andre17-hsx/peso-automatico-de-muestreo/hardware/pcb/render_bottom.png

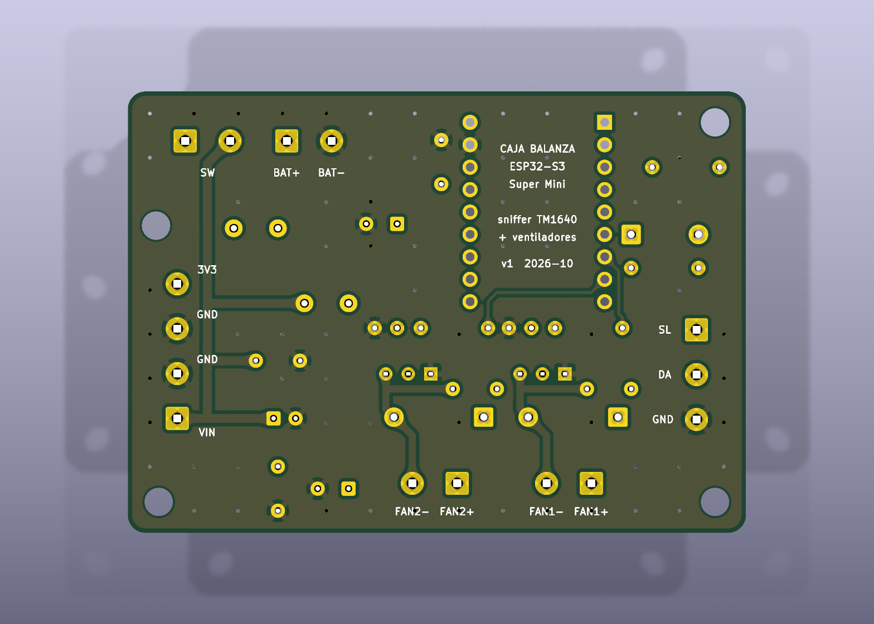
hardware/pcb/render_bottom.png
