andre17-hsx/peso-automatico-de-muestreo/hardware/pcb/render_iso.png

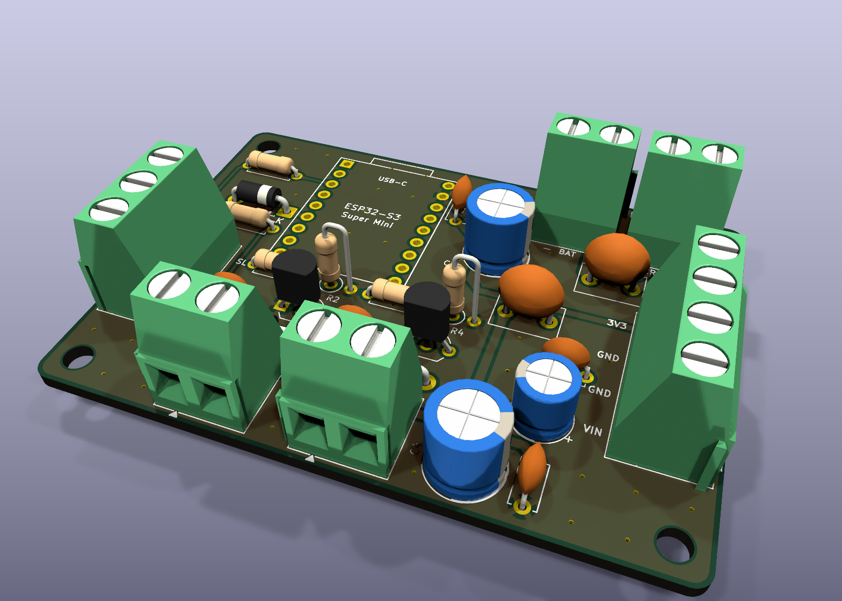
hardware/pcb/render_iso.png
