andre17-hsx/peso-automatico-de-muestreo/hardware/pcb/render_top.png

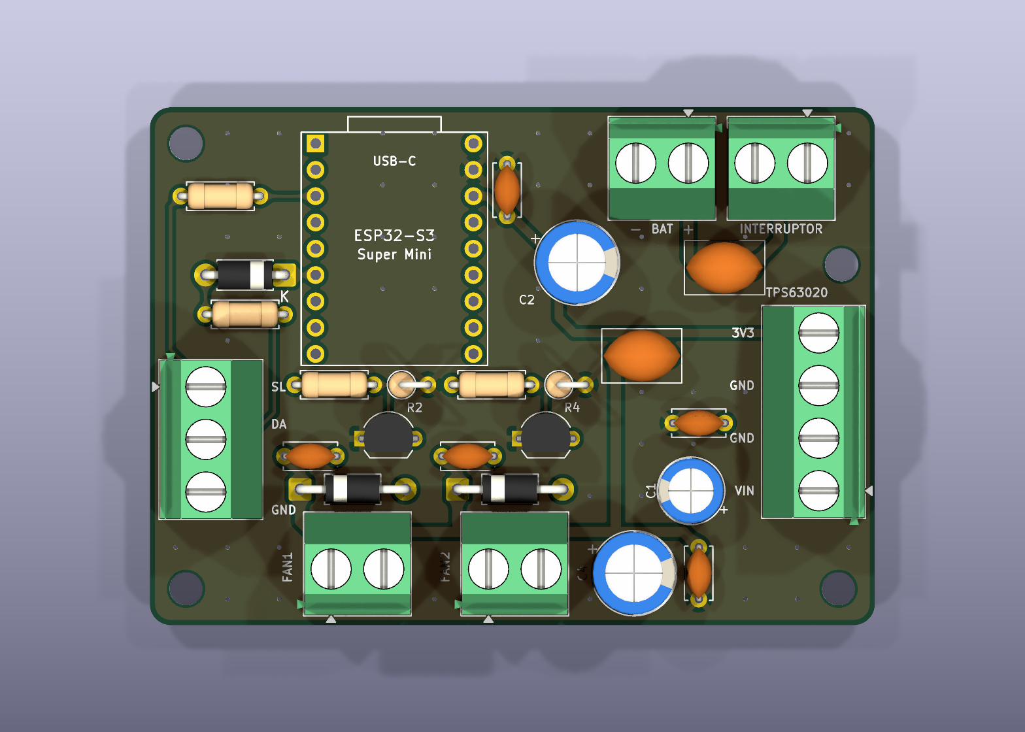
hardware/pcb/render_top.png
