andre17-hsx/peso-automatico-de-muestreo/hardware/pcb/v3/render_bottom.png

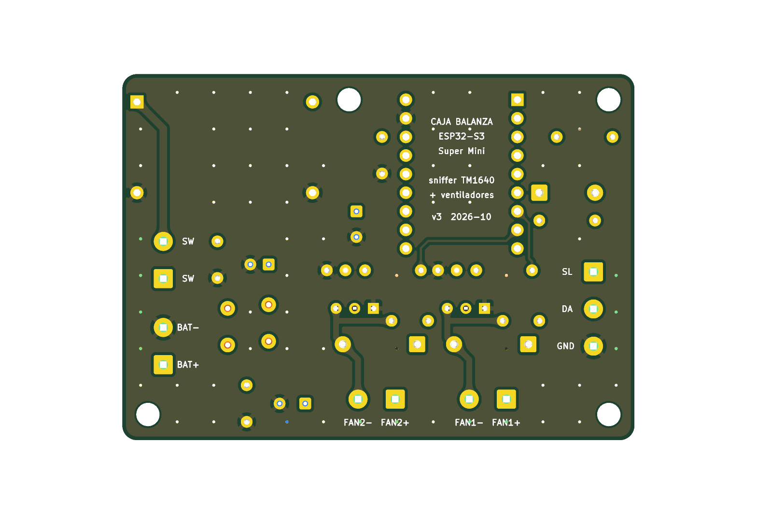
hardware/pcb/v3/render_bottom.png
