andre17-hsx/peso-automatico-de-muestreo/hardware/pcb/v3/render_iso.png

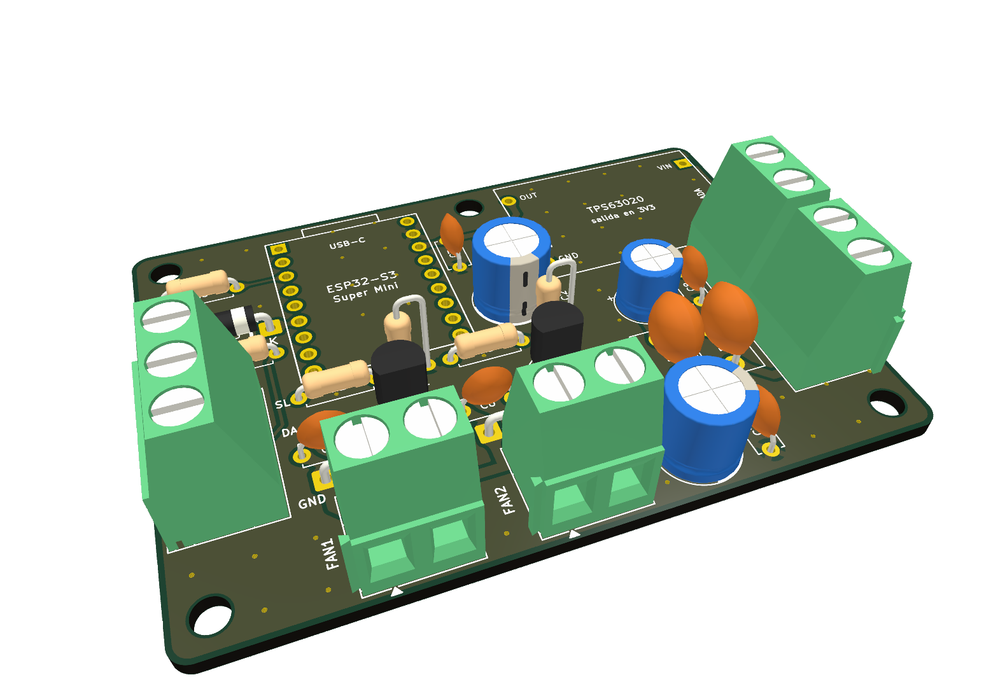
hardware/pcb/v3/render_iso.png
