andre17-hsx/peso-automatico-de-muestreo/hardware/pcb/BOM.csv

Ref | Qty | Value | Package / footprint | Note
U1 | 1 | ESP32-S3 Super Mini | 2 x 1x9 female headers, 2.54 mm (rows 15.24 mm apart) | The ESP keeps its male headers soldered and plugs in
J1 | 1 | 2-way terminal block (BAT - / +) | 5.08 mm, KF301 / MKDS 1.5 type | Scale battery
J2 | 1 | 2-way terminal block (SWITCH) | 5.08 mm | To the SW1 panel switch (>= 2 A)
J3 | 1 | 4-way terminal block (3V3 GND GND VIN) | 5.08 mm (or 2+2 interlocking) | To the TPS63020 module (short wires < 10 cm)
J4 J5 | 2 | 2-way terminal block (FAN + / -) | 5.08 mm | Red to +, black to -
J6 | 1 | 3-way terminal block (SL DA GND) | 5.08 mm | To the display connector
F1 | 1 | PTC 1.1 A hold (MF-R110) | radial, 5.1 mm lead pitch | Protects the whole board
F2 | 1 | PTC 0.75 A hold (MF-R075) | radial, 5.1 mm lead pitch | Fan branch only
C1 | 1 | 100 uF 16 V 105 C | electrolytic D6.3 mm, 2.5 mm pitch | TPS input
C8 | 1 | 10 uF 16 V X7R | ceramic, 5 mm pitch | TPS input
C2 | 1 | 470 uF 10 V 105 C | electrolytic D8 mm, 3.5 mm pitch | WiFi peaks, next to the 3V3 pin
C3 C5 C6 C7 | 4 | 100 nF 50 V (104) | ceramic, 5 mm pitch | Decoupling and motor noise
C4 | 1 | 470 uF 16 V 105 C | electrolytic D8 mm, 3.5 mm pitch | Fan start-up
R1 R3 R5 R6 | 4 | 470 ohm 1/4 W | axial, 7.62 mm pitch (lying flat) | yellow-violet-brown
R2 R4 | 2 | 10 kohm 1/4 W | axial standing, 2.54 mm pitch | brown-black-orange
Q1 Q2 | 2 | 2N2222 / PN2222A | TO-92, legs spread to 2.54 mm | E-B-C order (square = E), check with a multimeter
D1 D2 | 2 | 1N5819 | DO-41, 10.16 mm pitch | Band toward the square pad (cathode, +V_VENT side)
D3 | 1 | 1N5819 (or BAT85) | DO-41, 7.62 mm pitch | Band toward the ESP (square pad)
H1-H4 | 4 | M3 screw + standoff | 3.2 mm hole
