andre17-hsx/peso-automatico-de-muestreo/hardware/pcb/esquema_caja_balanza.pdf

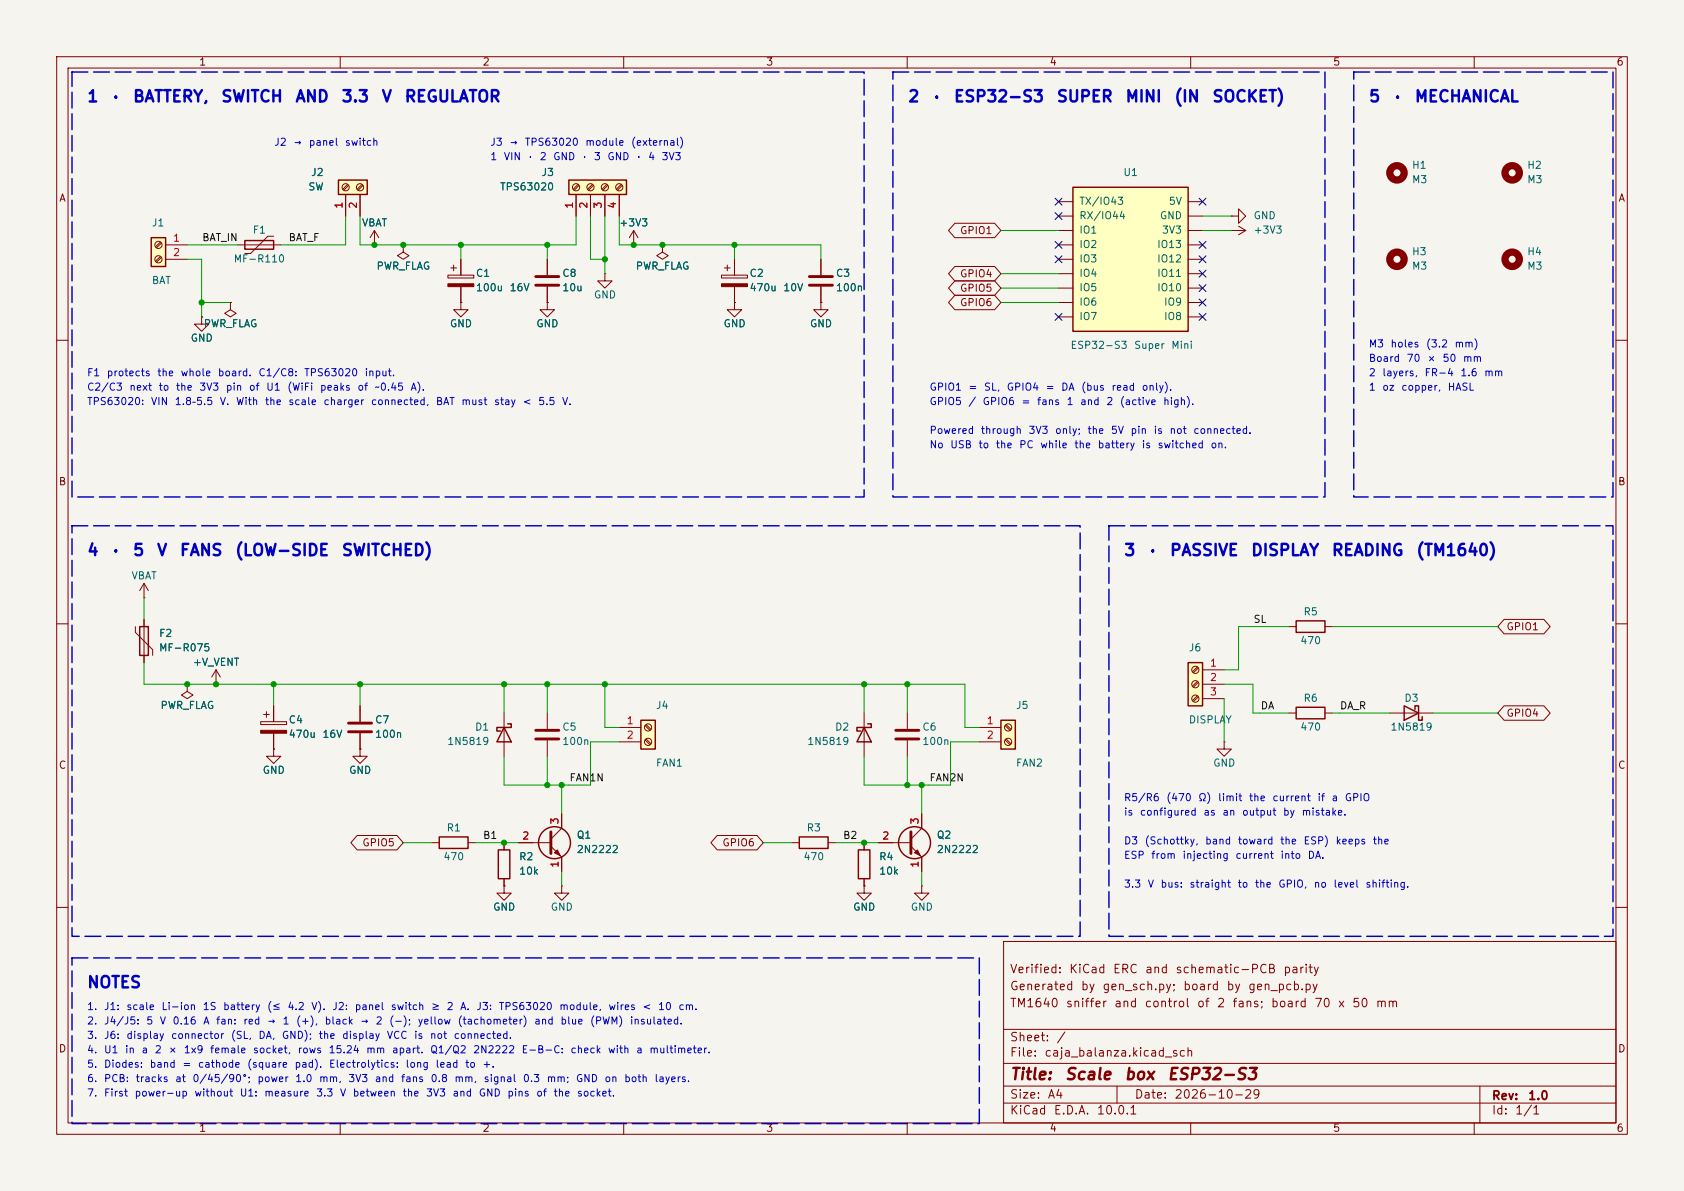
[picture p12: page 1]

1 · BATTERY, SWITCH AND 3.3 V REGULATOR

2 · ESP32-S3 SUPER MINI (IN SOCKET)

TPS63020: VIN 1.8–5.5 V. With the scale charger connected, BAT must stay < 5.5 V. C2/C3 next to the 3V3 pin of U1 (WiFi peaks of ~0.45 A). F1 protects the whole board. C1/C8: TPS63020 input.

1 oz copper, HASL 3 · PASSIVE DISPLAY READING (TM1640)

GPIO5 / GPIO6 = fans 1 and 2 (active high).

7. First power-up without U1: measure 3.3 V between the 3V3 and GND pins of the socket. 2. J4/J5: 5 V 0.16 A fan: red → 1 (+), black → 2 (−); yellow (tachometer) and blue (PWM) insulated. 1. J1: scale Li-ion 1S battery (≤ 4.2 V). J2: panel switch ≥ 2 A. J3: TPS63020 module, wires < 10 cm. 4 · 5 V FANS (LOW-SIDE SWITCHED)

is configured as an output by mistake. D3 (Schottky, band toward the ESP) keeps the ESP from injecting current into DA. 3.3 V bus: straight to the GPIO, no level shifting.

Verified: KiCad ERC and schematic-PCB parity
Generated by gen_sch.py; board by gen_pcb.py
TM1640 sniffer and control of 2 fans; board 70 x 50 mm

3. J6: display connector (SL, DA, GND); the display VCC is not connected.
4. U1 in a 2 × 1x9 female socket, rows 15.24 mm apart. Q1/Q2 2N2222 E-B-C: check with a multimeter.
5. Diodes: band = cathode (square pad). Electrolytics: long lead to +. 6. PCB: tracks at 0/45/90°; power 1.0 mm, 3V3 and fans 0.8 mm, signal 0.3 mm; GND on both layers.

Size: A4 | Rev: 1.0
KiCad E.D.A. 10.0.1 | Id: 1/1
