andre17-hsx/peso-automatico-de-muestreo/hardware/pcb/v2/caja_balanza_v2.kicad_pcb

## KiCad design hardware/pcb/v2/caja_balanza_v2.kicad_pcb (2026-10-29, an earlier design)

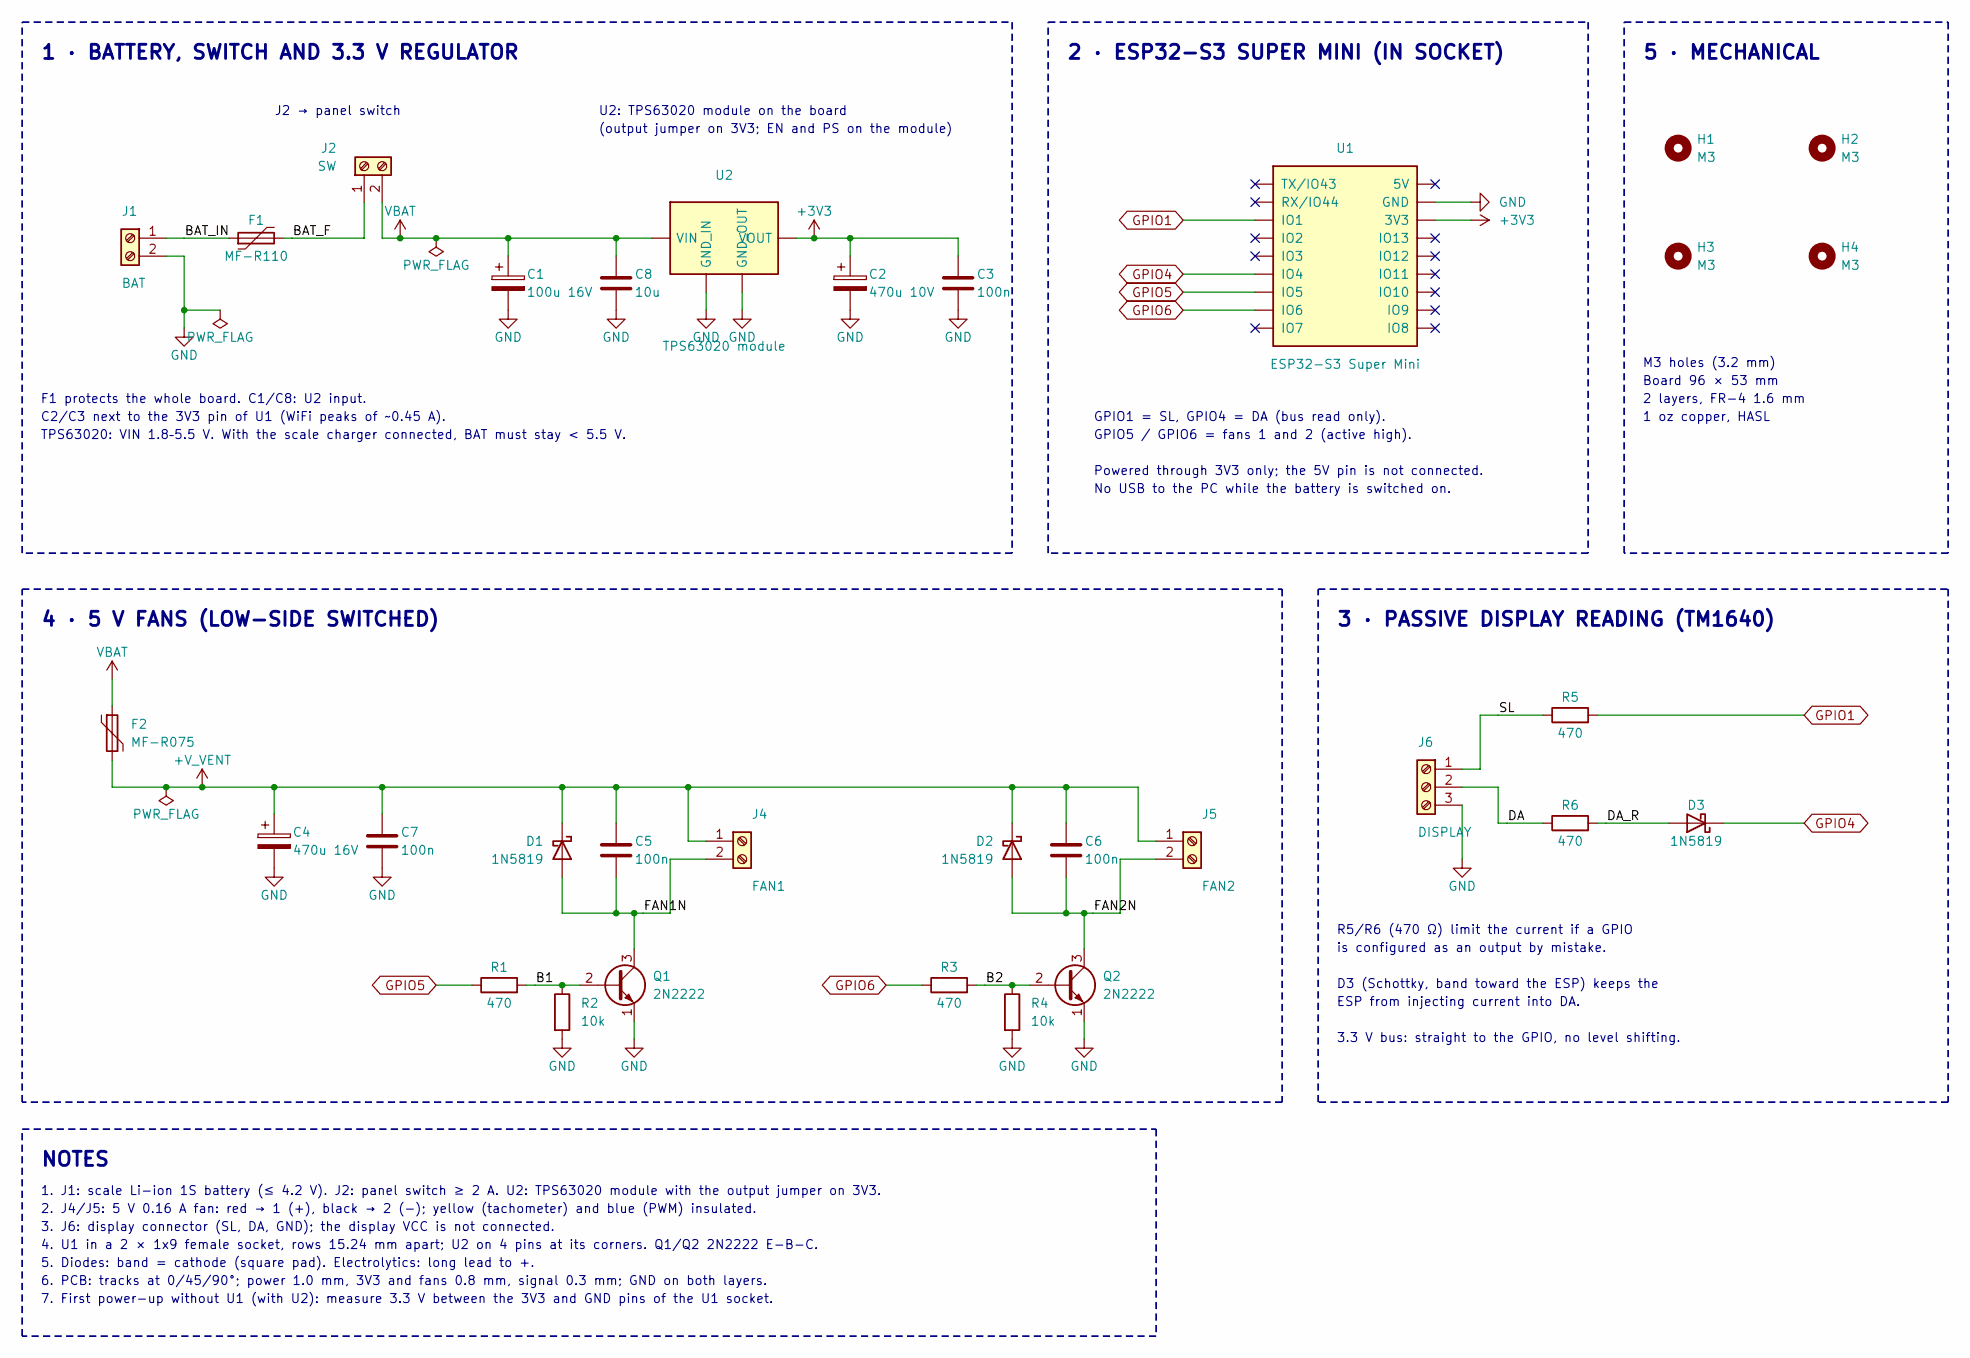
[picture p14: schematic caja_balanza_v2.kicad_sch, Scale box ESP32-S3]

Parts:
C1: 100u 16V; CP_Radial_D6.3mm_P2.50mm
C2: 470u 10V; CP_Radial_D8.0mm_P3.50mm
C3, C5, C6, C7: 100n; C_Disc_D5.0mm_W2.5mm_P5.00mm
C4: 470u 16V; CP_Radial_D8.0mm_P3.50mm
C8: 10u; C_Disc_D5.0mm_W2.5mm_P5.00mm
D1, D2: 1N5819; D_DO-41_SOD81_P10.16mm_Horizontal
D3: 1N5819; D_DO-41_SOD81_P7.62mm_Horizontal
F1: MF-R110; C_Disc_D7.5mm_W5.0mm_P5.00mm
F2: MF-R075; C_Disc_D7.5mm_W5.0mm_P5.00mm
H1, H2, H3, H4: M3; MountingHole_3.2mm_M3
J1: BAT; TerminalBlock_Phoenix_MKDS-1,5-2-5.08_1x02_P5.08mm_Horizont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
J2: SW; TerminalBlock_Phoenix_MKDS-1,5-2-5.08_1x02_P5.08mm_Horizont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
J4: FAN1; TerminalBlock_Phoenix_MKDS-1,5-2-5.08_1x02_P5.08mm_Horizont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
J5: FAN2; TerminalBlock_Phoenix_MKDS-1,5-2-5.08_1x02_P5.08mm_Horizont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
J6: DISPLAY; TerminalBlock_Phoenix_MKDS-1,5-3-5.08_1x03_P5.08mm_Horizont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
Q1, Q2: 2N2222; TO-92_Inline_Wide
R1, R3, R5, R6: 470; R_Axial_DIN0207_L6.3mm_D2.5mm_P7.62mm_Horizontal
R2, R4: 10k; R_Axial_DIN0207_L6.3mm_D2.5mm_P7.62mm_Horizontal
U1: ESP32-S3 Super Mini; ESP32-S3_SuperMini_Socket
U2: TPS63020 module; TPS63020_Module_26x18

Connections:
+3V3: C2.1, C3.1, U1.3V3, U2.4 (VOUT)
+V_VENT: C4.1, C5.1, C6.1, C7.1, D1.1 (K), D2.1 (K), F2.2, J4.1, J5.1
/B1: Q1.2 (B), R1.2, R2.1
/B2: Q2.2 (B), R3.2, R4.1
/BAT_F: F1.2, J2.1
/BAT_IN: F1.1, J1.1
/DA: J6.2, R6.1
/DA_R: D3.2 (A), R6.2
/FAN1N: C5.2, D1.2 (A), J4.2, Q1.3 (C)
/FAN2N: C6.2, D2.2 (A), J5.2, Q2.3 (C)
/SL: J6.1, R5.1
GND: C1.2, C2.2, C3.2, C4.2, C7.2, C8.2, J1.2, J6.3, Q1.1 (E), Q2.1 (E), R2.2, R4.2, U1.GND, U2.2 (GND_IN), U2.3 (GND_OUT)
GPIO1: R5.2, U1.1 (IO1)
GPIO4: D3.1 (K), U1.4 (IO4)
GPIO5: R1.1, U1.5 (IO5)
GPIO6: R3.1, U1.6 (IO6)
VBAT: C1.1, C8.1, F2.1, J2.2, U2.1 (VIN)

Notes on the sheet:
1 · BATTERY, SWITCH AND 3.3 V REGULATOR
J2 → panel switch
U2: TPS63020 module on the board
(output jumper on 3V3; EN and PS on the module)
F1 protects the whole board. C1/C8: U2 input.
C2/C3 next to the 3V3 pin of U1 (WiFi peaks of ~0.45 A).
TPS63020: VIN 1.8–5.5 V. With the scale charger connected, BAT must stay < 5.5 V.
2 · ESP32-S3 SUPER MINI (IN SOCKET)
GPIO1 = SL, GPIO4 = DA (bus read only).
GPIO5 / GPIO6 = fans 1 and 2 (active high).
Powered through 3V3 only; the 5V pin is not connected.
No USB to the PC while the battery is switched on.
5 · MECHANICAL
M3 holes (3.2 mm)
Board 96 × 53 mm
2 layers, FR-4 1.6 mm
1 oz copper, HASL
4 · 5 V FANS (LOW-SIDE SWITCHED)
3 · PASSIVE DISPLAY READING (TM1640)
R5/R6 (470 Ω) limit the current if a GPIO
is configured as an output by mistake.
D3 (Schottky, band toward the ESP) keeps the
ESP from injecting current into DA.
3.3 V bus: straight to the GPIO, no level shifting.
NOTES
1. J1: scale Li-ion 1S battery (≤ 4.2 V). J2: panel switch ≥ 2 A. U2: TPS63020 module with the output jumper on 3V3.
2. J4/J5: 5 V 0.16 A fan: red → 1 (+), black → 2 (−); yellow (tachometer) and blue (PWM) insulated.
3. J6: display connector (SL, DA, GND); the display VCC is not connected.
4. U1 in a 2 × 1x9 female socket, rows 15.24 mm apart; U2 on 4 pins at its corners. Q1/Q2 2N2222 E-B-C.
5. Diodes: band = cathode (square pad). Electrolytics: long lead to +.
6. PCB: tracks at 0/45/90°; power 1.0 mm, 3V3 and fans 0.8 mm, signal 0.3 mm; GND on both layers.
7. First power-up without U1 (with U2): measure 3.3 V between the 3V3 and GND pins of the U1 socket.

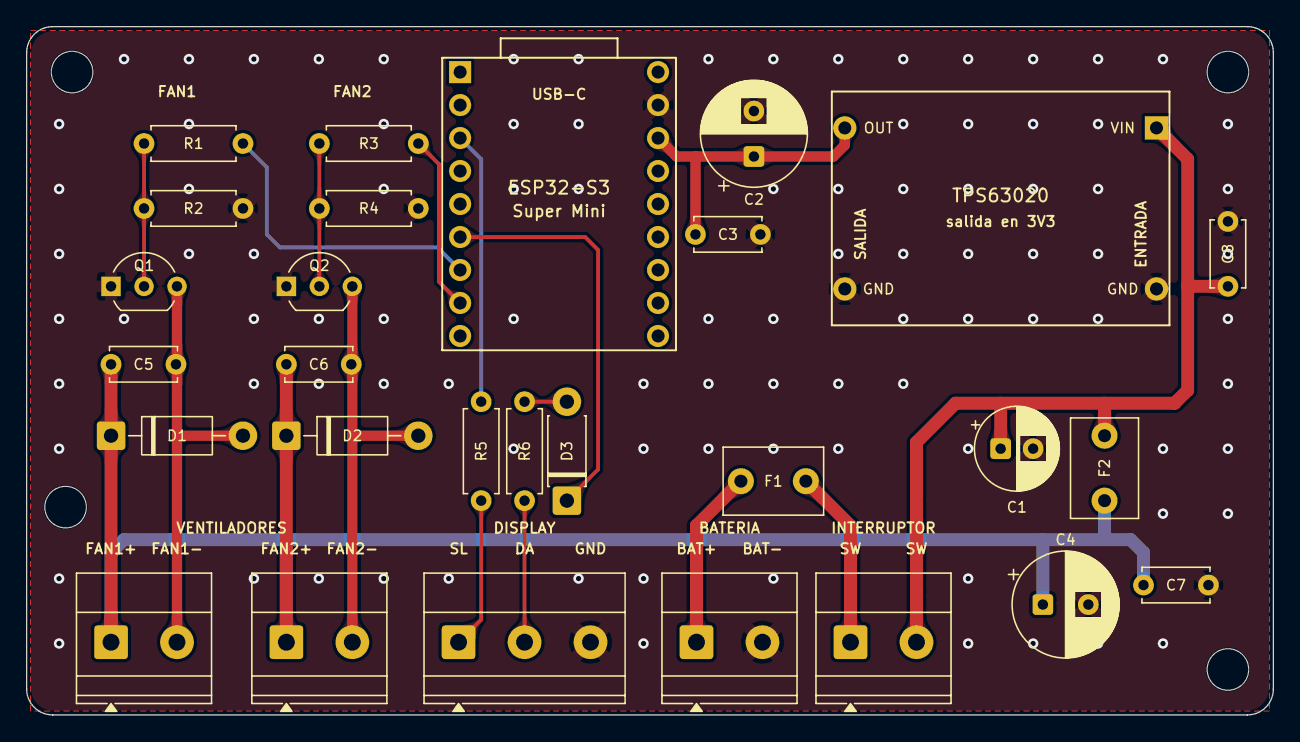
[picture p15: board caja_balanza_v2.kicad_pcb from above]

Board: 2 copper layers, 96.0 x 53.0 mm, 32 parts (0 on the bottom side), 17 nets.
