andre17-hsx/peso-automatico-de-muestreo/peso_balanza_cam/peso_balanza_cam.ino

/*
 * ===========================================================================
 *  peso_balanza_cam  -  Lee el PESO de la balanza cuenta-precio interceptando
 *                       el bus de su display y lo publica por WiFi (panel web).
 * ===========================================================================
 *
 *  Placa:   ESP32-S3 Super Mini  (chip ESP32-S3FH4R2: 4MB flash + 2MB PSRAM Quad,
 *           un solo USB-C nativo -- SIN chip CH340).
 *           (antes: DOIT ESP32-S3-WROOM N16R8 con FFC de camara; se cambio de
 *            modulo por daño de hardware.  Tambien se probo leer el display por
 *            camara/OCR -- ver el historial de git si hace falta recuperarlo --
 *            pero se descarto: el sniffer del bus da el valor EXACTO sin
 *            depender de luz/encuadre, asi que es lo unico que queda)
 *  Balanza: ACS-JC36CV28  -->  display WP-91110-2540-V7 (chip CS2540 == TM1640)
 *
 *  Sniffer del bus del display  (ENABLE_SNIFFER en config.h):
 *     escucha pasiva de DA (datos) y SL (reloj), decodifica el protocolo tipo
 *     TM1640 y reconstruye los 16 bytes de RAM -> PESO / PRECIO / TOTAL exactos.
 *     Corre en su PROPIA tarea de FreeRTOS (ver weighTaskFn mas abajo), asi que
 *     nunca se frena aunque el servidor web se quede esperando a un celular
 *     lento (WebServer puede tardar hasta 5 s en un cliente que no contesta).
 *
 * ---------------------------------------------------------------------------
 *  CONEXION DEL SNIFFER  (3 cables)  -- ver config.h
 * ---------------------------------------------------------------------------
 *     Balanza SL   --- [470 ohm] ------------------  GPIO1  (SNIF_PIN_SL)
 *     Balanza DA   --- [470 ohm] --- [diodo Schottky] --- GPIO4  (SNIF_PIN_DA)
 *                        (BAT54/1N5817/1N5819; anodo hacia la balanza, catodo
 *                         hacia el GPIO -- bloquea que una fuga interna del
 *                         ESP se devuelva hacia la balanza.  Ver README/chat:
 *                         asi se resolvio el bus "volviendose loco" con el
 *                         modulo anterior, que resulto tener 2 GPIO dañados
 *                         con fuga hacia el riel de 5V)
 *     Balanza GND  ------------------------------------------------  GND     (masa comun OBLIGATORIA)
 *
 *     NO conectar VCC_DIS.  Logica de 3 V -> entra directa al GPIO del S3.
 *     GPIO1 y GPIO4 limpios en esta placa.  Strapping S3 (0/3/45/46) y USB
 *     nativo (19/20) son del silicio, evitarlos sin importar la placa.  Esta
 *     placa no tiene conector de camara ni microSD, asi que ese bloqueo ya
 *     no aplica -- solo usa los 2 pines de arriba de todos modos.
 *     Durante la prueba: balanza con SU bateria, placa por USB-C.
 *
 * ---------------------------------------------------------------------------
 *  ARDUINO IDE   (chip ESP32-S3FH4R2 -- 4MB flash, 2MB PSRAM Quad)
 * ---------------------------------------------------------------------------
 *     Placa:              "ESP32S3 Dev Module"  (generico, sirve para esta placa)
 *     PSRAM:              "Disabled" (nada en este firmware la necesita)
 *     Flash Size:         "4MB (32Mb)"
 *     Partition Scheme:   uno pensado para 4MB que INCLUYA SPIFFS: ahi
 *                          (LittleFS) se guarda el historial COMPLETO de
 *                          pesajes (histarch.cpp); sin esa particion el
 *                          programa funciona igual, pero solo conserva los
 *                          ultimos 120.  El binario ocupa ~1,1 MB (no hay
 *                          OTA).  Pesajes que caben: "Minimal SPIFFS" (128KB)
 *                          ~4 000 · "Huge APP" (896KB) ~28 000 · "No OTA
 *                          (2MB APP/2MB SPIFFS)" ~61 000 (recomendado).
 *     USB CDC On Boot:    "Enabled"  (esta placa NO tiene CH340 -- solo el
 *                          USB-C nativo; si lo dejas en Disabled no vas a ver
 *                          NADA en el Monitor Serie)
 *     Core Debug Level:   "None"
 *
 *     Pon tu WiFi en config.h antes de compilar.
 * ===========================================================================
 */

#include <Arduino.h>
#include <WiFi.h>
#include <WebServer.h>
#include <ESPmDNS.h>
#include <time.h>
#include <stdlib.h>

#include "config.h"
#include "sniffer_tm1640.h"
#include "weighlog.h"
#include "diaglog.h"
#include "web_ui.h"
#include "weighsim.h"
#include "fan.h"
#include <esp_wifi.h>
#include <nvs.h>

// salud de la tarea del pesaje: loop() vigila que siga dando vueltas
static TaskHandle_t       g_weighTask   = nullptr;
static volatile uint32_t  g_weighBeatMs = 0;      // millis() de su ultima vuelta

#if WIFI_CAPTIVE
  #include <DNSServer.h>
  #include <esp_netif.h>
  DNSServer dnsServer;
  static bool g_apUp = false;      // hay un AP en marcha -> portal cautivo

  // Fuerza que el DHCP del AP entregue la IP del ESP como servidor DNS
  // (algunos cores no lo hacen solos y el portal cautivo no salta).
  static void apOfferOwnDns() {
    esp_netif_t* ni = esp_netif_get_handle_from_ifkey("WIFI_AP_DEF");
    if (!ni) return;
    esp_netif_dns_info_t dns; memset(&dns, 0, sizeof(dns));
    dns.ip.type = ESP_IPADDR_TYPE_V4;
    esp_netif_str_to_ip4("192.168.4.1", &dns.ip.u_addr.ip4);
    esp_netif_dhcps_stop(ni);
    esp_netif_set_dns_info(ni, ESP_NETIF_DNS_MAIN, &dns);
    uint8_t offerDns = 2;   // OFFER_DNS
    esp_netif_dhcps_option(ni, ESP_NETIF_OP_SET,
                           ESP_NETIF_DOMAIN_NAME_SERVER, &offerDns, sizeof(offerDns));
    esp_netif_dhcps_start(ni);
  }
#endif

WebServer server(80);

// Gracia tras levantar el AP: el driver puede soltar un AP_STOP espurio mientras
// termina de configurarse (y otro eco si lo relevantamos); no cuenta como caida.
#define AP_GRACE_MS 5000
static uint32_t g_apStartMs = 0;

// ---------------------------------------------------------------------------
static void wifiStartAP() {
  // IP fija 192.168.4.1; el DHCP del AP reparte esa misma IP como DNS -> hace
  // falta para el portal cautivo (el DNS "atrapatodo" del ESP).
  WiFi.softAPConfig(IPAddress(192, 168, 4, 1),
                    IPAddress(192, 168, 4, 1),
                    IPAddress(255, 255, 255, 0));
#ifdef WIFI_AP_CHANNEL
  WiFi.softAP(WIFI_AP_SSID, WIFI_AP_PASS, WIFI_AP_CHANNEL);
#else
  WiFi.softAP(WIFI_AP_SSID, WIFI_AP_PASS);
#endif
#ifdef WIFI_TX_POWER
  WiFi.setTxPower(WIFI_TX_POWER);
#endif
  Serial.printf("\n  ================ RED PROPIA DEL ESP32 ================\n"
                "   WiFi:   %s\n   Clave:  %s\n   Abrir:  http://%s/\n"
                "  =====================================================\n",
                WIFI_AP_SSID, WIFI_AP_PASS, WiFi.softAPIP().toString().c_str());
#if WIFI_CAPTIVE
  apOfferOwnDns();
  g_apUp = true;
#endif
  g_apStartMs = millis();      // arranca (o reinicia) la ventana de gracia
}

// ---------------------------------------------------------------------------
//  Auto-recuperacion del AP:  si el driver de WiFi lo llega a parar solo (p.
//  ej. por un bajon de tension momentaneo en la alimentacion), lo volvemos a
//  levantar.  Esto NO sustituye arreglar la alimentacion (C_out pendiente) --
//  es una red de seguridad para que el panel no se quede muerto hasta que
//  alguien reinicie el ESP a mano.
//
//  Dos vias, para cubrir los dos escenarios posibles:
//   1) El driver SI avisa (evento AP_STOP) -> reaccion inmediata.  El evento
//      llega en la tarea de WiFi, asi que aqui solo se marca una bandera; el
//      restart real lo hace loop() (evitar tocar el driver desde su propio
//      callback).
//   2) El driver NO avisa (se queda "zombie": el modo sigue en AP pero ya no
//      emite) -> red de seguridad barata: se revisa el modo cada 5 s,
//      aprovechando el heartbeat que ya existia (CERO temporizadores nuevos).
// ---------------------------------------------------------------------------
static volatile bool g_apNeedsRestart = false;
static uint32_t      g_apRecoverCount = 0;

static void wifiRecoverAP(const char* why) {
  g_apRecoverCount++;
  Serial.printf("[wifi] recuperando la red propia (%s) -> recuperacion #%lu\n",
                why, (unsigned long)g_apRecoverCount);
  diagLog("WIFI AP reinicio #%lu %s heap=%lu", (unsigned long)g_apRecoverCount, why,
          (unsigned long)ESP.getFreeHeap());
  wifiStartAP();
}

static void onWifiEvent(WiFiEvent_t event) {
  if (event == ARDUINO_EVENT_WIFI_AP_STOP) g_apNeedsRestart = true;   // lo procesa loop()
}

// Celulares que entran / salen de la red del ESP, para el registro (/log).
// Llega en la tarea de eventos de WiFi: solo se anota (sin floats ni esperas).
// motivo: 8 = el celular se fue · 3 = deauth · 4 = por inactividad ·
//         2 = autenticacion expirada · 15 = fallo de handshake
static void onWifiStaEvent(arduino_event_id_t ev, arduino_event_info_t info) {
  if (ev == ARDUINO_EVENT_WIFI_AP_STACONNECTED) {
    g_diagCnt.wifiConn++;
    diagLog("WIFI + cliente %02X:%02X aid=%d",
            (unsigned)info.wifi_ap_staconnected.mac[4], (unsigned)info.wifi_ap_staconnected.mac[5],
            (int)info.wifi_ap_staconnected.aid);
  } else if (ev == ARDUINO_EVENT_WIFI_AP_STADISCONNECTED) {
    g_diagCnt.wifiDisc++;
    diagLog("WIFI - cliente %02X:%02X motivo=%d",
            (unsigned)info.wifi_ap_stadisconnected.mac[4], (unsigned)info.wifi_ap_stadisconnected.mac[5],
            (int)info.wifi_ap_stadisconnected.reason);
  }
}

#if DIAG_LOG
// Resumen cada ~2 min para el registro: señal de cada celular, memoria y
// cuantos refrescos por segundo manda el display de la balanza.
static void diagStatus() {
  char rs[32] = "";
  int off = 0;
  wifi_sta_list_t sl;
  memset(&sl, 0, sizeof(sl));
  if (esp_wifi_ap_get_sta_list(&sl) == ESP_OK)
    for (int i = 0; i < sl.num && i < 4 && off < (int)sizeof(rs) - 6; i++)
      off += snprintf(rs + off, sizeof(rs) - off, "%d ", (int)sl.sta[i].rssi);
  unsigned fps = 0;
#if ENABLE_SNIFFER
  {
    static uint32_t lastCnt = 0, lastMs = 0;
    SnifState s; snifGet(s);
    uint32_t nowMs = millis();
    if (lastMs && nowMs > lastMs) fps = (unsigned)(((s.refreshCount - lastCnt) * 1000UL) / (nowMs - lastMs));
    lastCnt = s.refreshCount; lastMs = nowMs;
  }
#endif
  float tc = temperatureRead();                  // temperatura interna del chip (aprox., +-2-3 C)
  if (tc > g_diagCnt.tempMaxC) g_diagCnt.tempMaxC = tc;
  // formato compacto: con 4 celulares sigue cabiendo en los 64 caracteres de la linea
  diagLog("ST c=%d t=%.0f r[%s] h=%lu/%lu f=%u", WiFi.softAPgetStationNum(), (double)tc, rs,
          (unsigned long)ESP.getFreeHeap(), (unsigned long)ESP.getMinFreeHeap(), fps);
  // memoria contigua mas grande (fragmentacion), pila libre minima de cada tarea y
  // entradas de NVS usadas/total: para medir en la placa lo que la auditoria estimo
  nvs_stats_t ns = {};
  nvs_get_stats(nullptr, &ns);
  diagLog("MEM ma=%lu pila w=%u l=%u nvs=%u/%u", (unsigned long)ESP.getMaxAllocHeap(),
          g_weighTask ? (unsigned)uxTaskGetStackHighWaterMark(g_weighTask) : 0u,
          (unsigned)uxTaskGetStackHighWaterMark(nullptr),
          (unsigned)ns.used_entries, (unsigned)ns.total_entries);
  Serial.printf("[mem] ma=%lu pila w=%u l=%u nvs=%u/%u\n", (unsigned long)ESP.getMaxAllocHeap(),
                g_weighTask ? (unsigned)uxTaskGetStackHighWaterMark(g_weighTask) : 0u,
                (unsigned)uxTaskGetStackHighWaterMark(nullptr),
                (unsigned)ns.used_entries, (unsigned)ns.total_entries);
}

// Mide cuanto tarda cada vuelta del bucle principal (y cuanto de eso es el
// servidor web).  Solo anota si pasa de DIAG_STALL_MS, y como mucho 1 vez/s.
#define DIAG_STALL_MS 80
static void loopTiming(uint32_t loopUs, uint32_t webUs) {
  uint32_t lm = loopUs / 1000, wm = webUs / 1000;
  if (lm > g_diagCnt.maxLoopMs) g_diagCnt.maxLoopMs = lm;
  if (wm > g_diagCnt.maxWebMs)  g_diagCnt.maxWebMs  = wm;
  if (lm >= DIAG_STALL_MS) {
    g_diagCnt.slowLoops++;
    static uint32_t lastLog = 0;
    if (millis() - lastLog > 1000) {
      lastLog = millis();
      diagLog("BUCLE lento %lu ms (web %lu ms)", (unsigned long)lm, (unsigned long)wm);
    }
  }
}
#endif   // DIAG_LOG

// ---------------------------------------------------------------------------
//  Tarea del pesaje: sniffer + maquina de estados del pesaje, en su PROPIA
//  tarea de FreeRTOS -- ya NO viven dentro de loop().  Motivo (visto en campo,
//  /log real): server.handleClient() puede tardar hasta HTTP_MAX_DATA_WAIT
//  (5000 ms, WebServer.h) si un celular abre conexion y tarda en mandar datos;
//  mientras tanto, ANTES, nadie llamaba a snifLoop()/weighFeed() porque
//  estaban justo despues en el mismo loop() -- una gaveta puesta en esos 5 s
//  se podia perder entera, a veces sin dejar ni rastro en el registro.
//  Esta tarea se deja en el MISMO nucleo que arma el sniffer (setup(), nucleo
//  de Arduino) para que isrSlRise/isrDaChange sigan siendo del mismo nucleo
//  que las lee (snifLoop) -- asi el noInterrupts()/interrupts() que ya tenia
//  sniffer_tm1640.cpp para leer g_shadow[] sigue siendo valido tal cual, sin
//  tocar el ISR.  Lo que SI hacia falta (y se añadio en sniffer_tm1640.cpp)
//  es proteger con un portMUX la estructura SnifState completa: antes la
//  escribia snifLoop() y la leia la web SIEMPRE en el mismo hilo (nunca a la
//  vez); ahora son dos tareas distintas y pueden solaparse.
#if ENABLE_SNIFFER
#ifndef WEIGH_FEED_MS
#define WEIGH_FEED_MS 20
#endif
static void weighTaskFn(void*) {
  uint32_t tw = 0;
  for (;;) {
    g_weighBeatMs = millis();
    snifLoop();
    // cada WEIGH_FEED_MS (config.h, 20 ms ~= 50 Hz): mas muestras = pilla
    // mejor el transitorio al retirar la gaveta rapido.
    if (millis() - tw >= WEIGH_FEED_MS) {
      tw = millis();
#if WEIGH_SIM
      float p, pr, t; simSample(tw, &p, &pr, &t);  // gavetas FALSAS (config.h: WEIGH_SIM)
      weighFeed(p, pr, t, false, true);
#else
      SnifState s; snifGet(s);
      static uint32_t lastRefresh = 0;               // solo los refrescos NUEVOS cuentan como "quieto"
      bool fresh = (s.refreshCount != lastRefresh);
      lastRefresh = s.refreshCount;
      weighFeed(s.pesoVal, s.precioVal, s.totalVal,
                s.stable, s.valid && !isnan(s.pesoVal), fresh);
#endif
    }
    vTaskDelay(pdMS_TO_TICKS(1));     // cede CPU; el ritmo real lo marca WEIGH_FEED_MS arriba
  }
}
#endif

//  llamado cada 5 s desde el heartbeat que ya existia en loop() (ver mas abajo)
static void wifiCheckHealth() {
#if WIFI_MODE == 0
  bool apOk = (WiFi.getMode() == WIFI_MODE_AP);
#elif WIFI_MODE == 2
  bool apOk = (WiFi.getMode() == WIFI_MODE_APSTA);
#else
  bool apOk = true;    // modo 1 (solo STA): la reconexion al router es otro tema, no se toca aqui
#endif
  if (!apOk) wifiRecoverAP("modo WiFi inesperado");
}

#if WIFI_MODE == 1
// intenta unirse al router; devuelve true si conecta antes de 15 s
static bool wifiJoinRouter() {
  WiFi.begin(WIFI_SSID, WIFI_PASS);
  Serial.print("[wifi] uniendo al router");
  uint32_t t0 = millis();
  while (WiFi.status() != WL_CONNECTED && millis() - t0 < 15000) {
    delay(250); Serial.print('.');
  }
  Serial.println();
  if (WiFi.status() == WL_CONNECTED) {
    Serial.printf("[wifi] router OK  ->  http://%s/   (%s)\n",
                  WiFi.localIP().toString().c_str(), WIFI_SSID);
#if ENABLE_NTP
    configTzTime(TZ_POSIX, NTP_SERVER);         // NTP + zona horaria local
#endif
    return true;
  }
  Serial.println("[wifi] router no disponible");
  return false;
}
#endif

static void wifiConnect() {
  WiFi.persistent(false);
  WiFi.setSleep(false);
  WiFi.setHostname(WIFI_HOSTNAME);
  WiFi.onEvent(onWifiEvent);       // armado ANTES de levantar el AP, por si se cae ya de arranque
  WiFi.onEvent(onWifiStaEvent, ARDUINO_EVENT_WIFI_AP_STACONNECTED);      // para el registro /log
  WiFi.onEvent(onWifiStaEvent, ARDUINO_EVENT_WIFI_AP_STADISCONNECTED);

#if WIFI_MODE == 0                                // ---- SOLO AP (campo) ----
  WiFi.mode(WIFI_AP);
  wifiStartAP();
#elif WIFI_MODE == 2                              // ---- STA + AP a la vez ----
  WiFi.mode(WIFI_AP_STA);
  wifiStartAP();                                  // la red propia esta lista YA
  WiFi.begin(WIFI_SSID, WIFI_PASS);               // y se une al router en segundo plano
  #if ENABLE_NTP
  configTzTime(TZ_POSIX, NTP_SERVER);             // SNTP + zona horaria local
  #endif
  Serial.println("[wifi] router en segundo plano (no bloquea; NTP si conecta)");
#else                                             // ---- SOLO STA (1) ----
  WiFi.mode(WIFI_STA);
  if (!wifiJoinRouter()) {
  #if WIFI_AP_FALLBACK
    WiFi.mode(WIFI_AP);
    wifiStartAP();
  #endif
  }
#endif

  if (MDNS.begin(WIFI_HOSTNAME))
    Serial.printf("[mdns] http://%s.local/\n", WIFI_HOSTNAME);

#if WIFI_CAPTIVE
  if (g_apUp) {
    // DNS "atrapatodo": CUALQUIER dominio -> la IP del ESP.  Con eso, la
    // deteccion de portal del movil (Android/iOS/Windows sondean una URL fija)
    // cae en nuestro servidor y este responde con un redirect al panel.
    dnsServer.setTTL(3600);
    dnsServer.start(53, "*", WiFi.softAPIP());
    Serial.println("[wifi] portal cautivo ON (DNS *)  ->  el movil abre el panel solo");
  }
#endif
}

// ---------------------------------------------------------------------------
void setup() {
  fanBegin();                                   // ventiladores apagados desde el primer instante
  Serial.begin(115200);
  delay(200);
  setCpuFrequencyMhz(240);                      // maximo: captura del bus + servidor web
  setenv("TZ", TZ_POSIX, 1); tzset();           // hora local para MOSTRAR (se guarda en UTC)
  Serial.println("\n=== Peso automatico de muestreo (ESP32-S3) ===");
  Serial.printf("[modo] SNIFFER=%d  WIFI_MODE=%d\n", ENABLE_SNIFFER, WIFI_MODE);

  diagBegin();                         // registro /log: anota el motivo del ultimo reinicio
  weighBegin();                        // recupera el historial guardado en NVS
  diagBootReport();                    // informe del reinicio anterior -> flash (ya montada)

#if ENABLE_SNIFFER
  snifBegin();
  Serial.printf("[snif] escuchando el bus  SL=GPIO%d  DA=GPIO%d\n",
                SNIF_PIN_SL, SNIF_PIN_DA);
#if WEIGH_SIM
  simBegin();
#endif
  // mismo nucleo que este setup() (ver comentario junto a weighTaskFn mas arriba)
  // 8 KB, como loop(): el guardado (NVS + archivo LittleFS + printf) corre en esta tarea
  if (xTaskCreatePinnedToCore(weighTaskFn, "weigh", 8192, nullptr, 1, &g_weighTask, xPortGetCoreID()) != pdPASS) {
    Serial.println("[pesaje] ERROR: no se pudo crear la tarea del pesaje");
    diagLog("ERROR: tarea del pesaje NO creada (no se pesa)");
  }
#endif

  wifiConnect();
  webBegin(server);
  server.begin();
  Serial.println("[web] servidor en marcha");
}

// ---------------------------------------------------------------------------
void loop() {
#if DIAG_LOG
  const uint32_t loopT0 = micros();
#endif
  if (g_apNeedsRestart) {
    g_apNeedsRestart = false;
    if (millis() - g_apStartMs >= AP_GRACE_MS) wifiRecoverAP("evento AP_STOP");   // dentro de la gracia: se ignora
  }

#if WIFI_CAPTIVE
  if (g_apUp) dnsServer.processNextRequest();
#endif
#if DIAG_LOG
  const uint32_t webT0 = micros();
#endif
  server.handleClient();      // el sniffer+pesaje ya NO se hacen aqui: van en su propia tarea
#if DIAG_LOG
  const uint32_t webUs = micros() - webT0;
#endif

  static uint32_t hb = 0;
  if (millis() - hb > 5000) {
    hb = millis();
    Serial.print("[hb]");
#if ENABLE_SNIFFER
    { SnifState s; snifGet(s);
      Serial.printf("  BUS valid:%d stable:%d  peso\"%s\"=%.2f  precio\"%s\"=%.2f  total\"%s\"=%.2f",
        s.valid, s.stable,
        s.peso,   (double)s.pesoVal,
        s.precio, (double)s.precioVal,
        s.total,  (double)s.totalVal); }
#endif
    Serial.printf("  pesaje:%s cap:%.2f  rssi:%d  heap:%lu(min %lu)  APcli:%d  APrec:%lu  vent:%d t:%.0f\n",
                  weighStateName(), weighLatched(), (int)WiFi.RSSI(),
                  (unsigned long)ESP.getFreeHeap(), (unsigned long)ESP.getMinFreeHeap(),
                  WiFi.softAPgetStationNum(), (unsigned long)g_apRecoverCount,
                  fanIsOn() ? 1 : 0, (double)fanTempAvg());
    wifiCheckHealth();     // red de seguridad: por si el AP quedo "zombie" sin avisar
#if ENABLE_SNIFFER
    {                      // la tarea del pesaje da una vuelta cada ~1 ms: 5 s sin vueltas = colgada
      static bool stuck = false;
      uint32_t age = millis() - g_weighBeatMs;
      if (g_weighTask && age > 5000 && !stuck) { stuck = true; diagLog("PESAJE detenido hace %lu ms", (unsigned long)age); }
      else if (age <= 5000 && stuck)           { stuck = false; diagLog("PESAJE reanudado"); }
    }
#endif
  }
  fanUpdate(millis());     // ventilacion de la caja (mide cada FAN_CHECK_MS)

#if DIAG_LOG
  {
    static uint32_t st = 0;
    if (millis() - st >= 120000UL) { st = millis(); diagStatus(); }
    loopTiming(micros() - loopT0, webUs);
  }
#endif
}
