andre17-hsx/peso-automatico-de-muestreo/peso_balanza_cam/icon_png.h

#pragma once
#include <Arduino.h>

// Icono del panel (192x192 PNG): pantalla de inicio del celular ("Balanza") y pestana.
// Generado con un script de Python a partir de formas simples; para cambiarlo, sustituye
// los bytes por los de otro PNG (idealmente 192x192, pocos KB).
static const uint8_t ICON_PNG[] PROGMEM = {
  0x89, 0x50, 0x4e, 0x47, 0x0d, 0x0a, 0x1a, 0x0a, 0x00, 0x00, 0x00, 0x0d, 0x49, 0x48, 0x44, 0x52,
  0x00, 0x00, 0x00, 0xc0, 0x00, 0x00, 0x00, 0xc0, 0x08, 0x03, 0x00, 0x00, 0x00, 0x65, 0x02, 0x9c,
  0x35, 0x00, 0x00, 0x00, 0x90, 0x50, 0x4c, 0x54, 0x45, 0xe9, 0xee, 0xf8, 0xa6, 0xdc, 0xe9, 0x5b,
  0xca, 0xda, 0x5a, 0xc8, 0xd8, 0x65, 0xbf, 0xd1, 0x45, 0x96, 0xa6, 0x21, 0x36, 0x4d, 0x1f, 0x2d,
  0x49, 0x1f, 0x2d, 0x48, 0x1f, 0x2d, 0x47, 0x17, 0x2d, 0x3c, 0x1d, 0x2a, 0x41, 0x18, 0x25, 0x3c,
  0x15, 0x22, 0x3c, 0x15, 0x22, 0x3b, 0x12, 0x22, 0x32, 0x15, 0x21, 0x3a, 0x14, 0x21, 0x3a, 0x14,
  0x20, 0x39, 0x15, 0x21, 0x37, 0x14, 0x20, 0x38, 0x12, 0x20, 0x33, 0x13, 0x1f, 0x36, 0x13, 0x1e,
  0x35, 0x12, 0x1d, 0x33, 0x11, 0x1c, 0x31, 0x11, 0x1b, 0x30, 0x10, 0x1b, 0x2f, 0x10, 0x1a, 0x2e,
  0x0f, 0x19, 0x2c, 0x0f, 0x18, 0x2a, 0x0e, 0x17, 0x29, 0x0d, 0x17, 0x29, 0x0d, 0x16, 0x27, 0x0d,
  0x15, 0x26, 0x0d, 0x15, 0x25, 0x0c, 0x15, 0x26, 0x0c, 0x14, 0x25, 0x0c, 0x14, 0x24, 0x0c, 0x14,
  0x23, 0x0c, 0x13, 0x23, 0x0c, 0x13, 0x22, 0x0b, 0x13, 0x22, 0x0b, 0x12, 0x21, 0x0b, 0x12, 0x20,
  0x0b, 0x12, 0x1f, 0x08, 0x12, 0x24, 0x08, 0x0e, 0x1e, 0xc8, 0xee, 0xdc, 0xc7, 0x00, 0x00, 0x05,
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
  0x16, 0xc3, 0x43, 0x94, 0x8c, 0xa9, 0x65, 0x14, 0xe0, 0x1c, 0xbc, 0x79, 0xb3, 0xd8, 0x25, 0xc6,
  0x69, 0x34, 0xae, 0x8e, 0xe1, 0x00, 0xd4, 0x4f, 0x18, 0xe5, 0x15, 0xab, 0xd5, 0xf5, 0x6a, 0x47,
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
};
