andre17-hsx/peso-automatico-de-muestreo/peso_balanza_cam/histarch.h

#pragma once
#include <Arduino.h>

// ===========================================================================
//  histarch  -  archivo PERMANENTE de pesajes (LittleFS, particion "spiffs")
// ---------------------------------------------------------------------------
//  El buffer circular de weighlog guarda solo los ultimos WEIGH_LOG_SIZE
//  pesajes.  Este modulo guarda TODOS (hasta que se pulse "Borrar todo") en un
//  archivo de solo-añadir:
//     /hist2.bin : registros de 16 bytes (HRec), en orden de id
//     /del.bin   : ids borrados a mano (uint32 cada uno)
//  Hasta 2026-11-06 era /hist.bin con registros de 24 bytes (incluia precio y
//  total); histBegin() lo convierte UNA vez al formato nuevo (ver histarch.cpp).
//  Es OPCIONAL y a prueba de fallos: si LittleFS no monta (esquema de
//  particiones sin "spiffs") o el archivo se llena, weighlog sigue funcionando
//  exactamente como antes con su buffer.  WEIGH_ARCHIVE 0 lo desactiva.
// ===========================================================================

struct __attribute__((packed)) HRec {
  uint32_t id;        // nº de pesaje (el mismo id que usa weighlog)
  float    peso;
  int32_t  epoch;     // hora UTC (s), 0 = desconocida
  uint16_t malla;
  uint16_t bin;
};                    // 16 bytes

bool     histBegin();                      // monta LittleFS y carga los borrados; false = sin archivo
bool     histMountFailed();                // la particion tiene datos pero NO monta (no se formateo: aviso)

// Candado del archivo: la tarea del pesaje (que archiva) y la web (borrar, CSV)
// no deben tocarlo a la vez.  Quien llama a las funciones de abajo desde dos
// tareas distintas toma el candado alrededor.  waitMs = 0 -> no espera (para la
// tarea del pesaje, que nunca debe quedarse bloqueada: si esta ocupado, lo deja
// para el proximo lote).  HIST_WAIT_FOREVER = espera lo que haga falta.
#define HIST_WAIT_FOREVER 0xFFFFFFFFu
bool     histLock(uint32_t waitMs);
void     histUnlock();
bool     histReady();                      // montado y legible
bool     histWritable();                   // se pueden seguir añadiendo registros
bool     histFull();                       // se alcanzo la capacidad reservada
uint8_t  histUsedPct();                    // % de la capacidad usado (0..100)
uint32_t histCount();                      // registros en el archivo (incluye los borrados)
uint32_t histLastId();                     // mayor id archivado (0 = vacio)

// Añade registros (ids ascendentes) con UNA sola escritura.  Devuelve cuantos
// quedaron guardados: si no caben todos guarda el prefijo que quepa, asi el
// archivo nunca tiene huecos.  Nunca bloquea ni rompe el pesaje si falla.
size_t   histAppendMany(const HRec* r, size_t n);

void     histMarkDeleted(uint32_t id);     // borrado a mano (se persiste)
bool     histIsDeleted(uint32_t id);
void     histClear();                      // borra archivo y borrados ("Borrar todo")

// Recorre en orden (mas viejo primero) los registros NO borrados.  cb devuelve
// false para parar.
typedef bool (*HistVisit)(const HRec& r, void* ctx);
void     histForEach(HistVisit cb, void* ctx);
