andre17-hsx/peso-automatico-de-muestreo/(commit log)

2026-09-21 Peso automatico de muestreo: sniffer TM1640 + panel web en ESP32-S3
    Lee el peso de una balanza cuenta-precio (ACS-JC36CV28) escuchando de forma
    pasiva el bus DA/SL del display, guarda el historial en NVS con agrupacion
    malla/BIN y lo publica por WiFi (AP propio + portal cautivo) con panel web.
    config.h (claves WiFi) no se versiona: copiar config.example.h a config.h.
2026-09-21 Actualizar README a la placa Super Mini y al firmware actual
    Raiz: tabla de sketches y pines (GPIO1/GPIO4 + diodo Schottky), Fase 2 hecha,
    nota de montaje en caja externa.
    peso_balanza_cam: configuracion actual (solo sniffer, WIFI_MODE 0), umbrales
    WEIGH_* reales en lb, reglas de mallas/BIN (malla se reinicia por BIN), panel
    con sector/piscina y pop-up, CSV y rutas nuevas (/targets, /info),
    recuperacion automatica del AP, alimentacion y montaje, problemas conocidos.
2026-09-21 CSV: orden del pesaje 1 al n y sin columna hace_s
    El CSV ahora empieza por la medicion mas antigua (n=1) y termina en la mas
    reciente. Se elimina la columna hace_s (ya esta hora_local). README actualizado.
2026-09-21 Historial permanente de pesajes en LittleFS y ajustes del panel
    - histarch.h/.cpp: archivo de solo-añadir en la particion SPIFFS con TODOS los
    pesajes hasta "Borrar todo". Se escribe en lotes de 8 (HIST_BATCH); entre lote
    y lote los pesajes ya estan a salvo en el buffer de NVS. Si LittleFS no monta
    o se llena, el programa sigue con el buffer como antes (WEIGH_ARCHIVE 0 lo apaga).
    - weighlog: nº de muestras y subtotales de BIN/malla sobre todo el historial;
    el CSV trae archivo + buffer.
    - Panel: historial ordenado de menor a mayor (BIN 1 > Malla 1, 2, 3...), aviso
    de memoria del historial, y se quita "hace N s".
    - README y comentarios actualizados (particion SPIFFS recomendada: No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
2026-09-25 Captura tolerante, registro de diagnostico /log y panel resistente
    Tras la prueba de campo (130 gavetas, ~8 sin guardar; panel a veces congelado
    con valores viejos):
    - weighlog: captura por ventana tolerante (WEIGH_PLATEAU 1). Un valor se da por
    asentado si las lecturas de los ultimos 250 ms varian < 0,15 lb. La referencia
    es el primer valor asentado DE ESA gaveta y despues solo se aceptan valores a
    menos de max(1 lb, 3 %) de ella, asi que nunca se guarda un valor de la caida
    a cero al retirar la gaveta. Solo el primer segundo permite subir la referencia.
    WEIGH_PLATEAU 0 restaura exactamente el criterio anterior.
    - diaglog.h/.cpp + /log: registro en RAM (sin flash ni Serial, solo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
2026-09-25 Añadir LICENSE: todos los derechos reservados (solo consulta / portafolio)
    El codigo se publica solo para consulta y como muestra de trabajo. No se
    concede licencia para copiarlo, modificarlo, redistribuirlo, venderlo ni usarlo
    en otros proyectos (comerciales o no) sin autorizacion escrita de los titulares;
    se exceptua lo que los Terminos de Servicio de GitHub permiten (ver y hacer
    fork dentro de GitHub). Texto en español e ingles, con aviso de "sin garantia".
    README: seccion "Licencia" con el resumen.
2026-09-25 Añadir capturas del panel web al README
    Cinco capturas del panel (modo claro, modo oscuro, historial por BIN y malla,
    aviso de malla completada y aviso de SIN SEÑAL) en docs/. Son del panel real
    alimentado por un ESP simulado con datos de ejemplo, no mediciones reales.
2026-09-25 Simplificar el texto de configuracion en README y .gitignore
2026-09-25 README: explicar como se intercepta y decodifica el bus del display
    Nueva seccion en la Fase 1: que viaja por el bus (SL/DA, START/STOP, 1 byte por
    digito), como el ESP lo escucha sin escribir (dos interrupciones + RAM espejo de
    16 bytes) y como se convierte en PESO / PRECIO / TOTAL (mapa de bytes, tabla de
    7 segmentos, decimales, tolerancia a iconos y ruido).
    Correccion: "estable" no es un bit del bus, lo calcula el sniffer (mismo peso
    durante SNIF_STABLE_N refrescos); se ajustan los textos que decian lo contrario.
2026-09-25 README: añadir el diagrama de la trama del bus del display
    Diagrama SVG (versiones clara y oscura, GitHub elige segun el tema) con tres
    partes: la trama completa (START, 0xC0|dir, 16 bytes agrupados en PESO/PRECIO/
    TOTAL, STOP), los dos hilos SL/DA bit a bit con los flancos en los que el ESP
    muestrea, y como un byte se convierte en un digito de 7 segmentos.
2026-10-02 Pesaje en tarea propia, sin camara/OCR, y rescate de gavetas sin asentar
    - El sniffer y la maquina de estados del pesaje corren en una tarea de
    FreeRTOS dedicada: el servidor web ya no puede bloquearlos hasta 5 s
    (causa real de pesajes perdidos en campo). Estado del sniffer protegido
    con seccion critica; weighClear() pide el reinicio por bandera.
    - Eliminado todo el codigo de camara y OCR (ocr7seg, rutas web, config).
    - Buffer del registro /log configurable (DIAG_LOG_LINES, 1024 por defecto).
    - Chequeo de plausibilidad (WEIGH_PLAUS_FRAC 0.7): se descarta el valor
    asentado si despues de asentar el peso subio por encima de valor/0.7
    (caso real de 5.3 lb). Un golpe al poner no lo acti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
2026-10-23 Ventiladores por temperatura, regla simple de pesaje y filtro "quieto"
    - Ventilacion de la caja (fan.cpp/.h): dos ventiladores en GPIO5/GPIO6 con
    histeresis sobre la media de 30 s de la temperatura del chip (ON 68 C,
    OFF 60 C, minimo 60 s encendidos); sin dato del sensor, ventila.
    - Pesaje: una gaveta empieza a las 12 lb y se guarda al pasar por cero
    (valor estable, o el valor sostenido, o 0,92 x maximo).
    - Valor sostenido: primero solo refrescos nuevos del display que repiten el
    anterior ("quieto"); si no hay, el calculo anterior.
    - /log: maximo de temperatura desde el arranque y estado de los ventiladores.
    - Simulador de pesajes (WEIGH_SIM) e icono del panel.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
2026-10-23 Esquema de la caja y ventiladores con 2N2222
    - docs/esquema-caja-claro.svg / -oscuro.svg: esquema completo (alimentacion,
    Super Mini con sus pines en posicion real, dos canales de ventilador y
    sniffer del display), enlazado desde el README de peso_balanza_cam.
    - README: canal de ventilador con 2N2222 (470 ohm en la base, 10 k a GND),
    calculo de saturacion, ventiladores de 4 cables (amarillo y azul aislados),
    C4 470 uF y F2 PTC 0,75 A.
    - Comentarios de fan.cpp/.h y config.example.h al transistor NPN; valores por
    defecto de fan.cpp alineados con 68/60 C.
2026-10-23 README: mostrar el esquema de la caja en la seccion Montaje
2026-10-28 Caja negra de reinicios y correcciones de la auditoria del firmware
    - Diagnostico: caja negra en memoria RTC (ultimas 96 lineas), resumen del
    coredump (tarea, causa, motivo del sistema, firmware igual/otro) e informe
    de cada reinicio inesperado en flash con nº de arranque y fecha; boton para
    borrarlos (POST /log/clear). Linea MEM con memoria, pilas y uso de NVS, y
    aviso si la tarea del pesaje se detiene.
    - Pesaje: cierre por 3 refrescos nuevos del display en cero (un refresco
    erroneo ya no cierra la gaveta); display congelado o ilegible con gaveta
    guarda el ultimo valor estable o el estimado y espera a ver cero.
    - Almacenamiento: candado del archivo entre la tarea del pesaje y l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
2026-10-29 Box PCB designs (v1, v2, v3) and English documentation
    - hardware/pcb: KiCad 10 schematic and 2-layer through-hole PCB for the
    box, generated by script (gen_sch.py, gen_pcb*.py) with ERC, DRC,
    schematic-PCB parity and an octilinear routing check at zero.
    v1: 70 x 50 mm, TPS63020 module off-board through a terminal block.
    v2: 96 x 53 mm, all terminal blocks in one row, TPS63020 on the board.
    v3: 70 x 50 mm, v1 layout with the TPS63020 module on the board.
    Each version has Gerbers, BOM, schematic PDF and 3D renders.
    - README and the box/frame diagrams in docs/ translated to English;
    README links the three PCB versions.
2026-11-06 Panel rediseñado, refresco adaptativo, historial por BIN y pesajes sin precio/total
    - Umbral minimo de gaveta: 12 -> 4 lb (en campo hay gavetas de 5 lb).
    - Panel: consulta /api cada 0,25 s con peso en la balanza y cada 1 s en
    reposo; historial visual solo del BIN en curso (boton "Ver BIN
    anteriores"); nuevo orden (sector/piscina, pantalla solo con el peso,
    ultimo pesaje, malla y BIN con barra de progreso, total, historial);
    accesibilidad WCAG 2.1 AA (contraste, 44 px, borrar con un toque).
    - Direccion mDNS: balanza.local.
    - Precio y total ya no se guardan: archivo /hist2.bin de 16 bytes por
    pesaje (conversion unica y segura desde /hist.bin), slots NVS de 12
    bytes (lee los format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
